JamesByers/fireflies_project/assets/800kHz_original_and_level_shifted_double_1_5.png

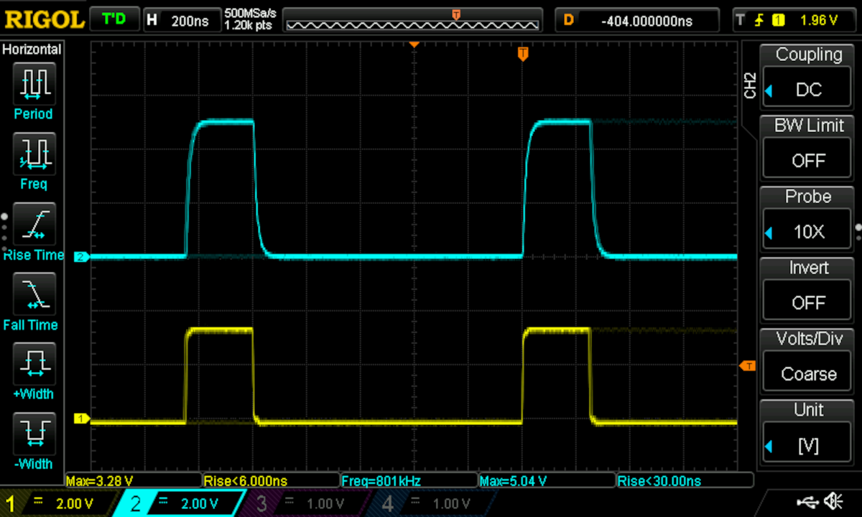
assets/800kHz_original_and_level_shifted_double_1_5.png
