JamesByers/fireflies_project/assets/Fireflies_2_1_0_board_3d.png

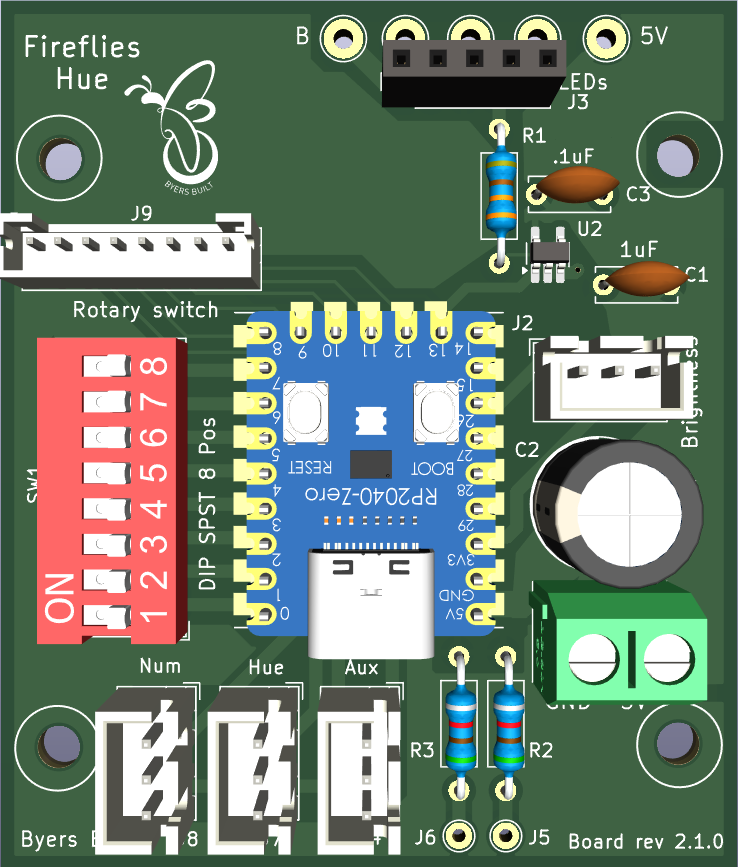
assets/Fireflies_2_1_0_board_3d.png
