JamesByers/fireflies_project/assets/Fireflies_hue_2_2_0_pcb_design.png

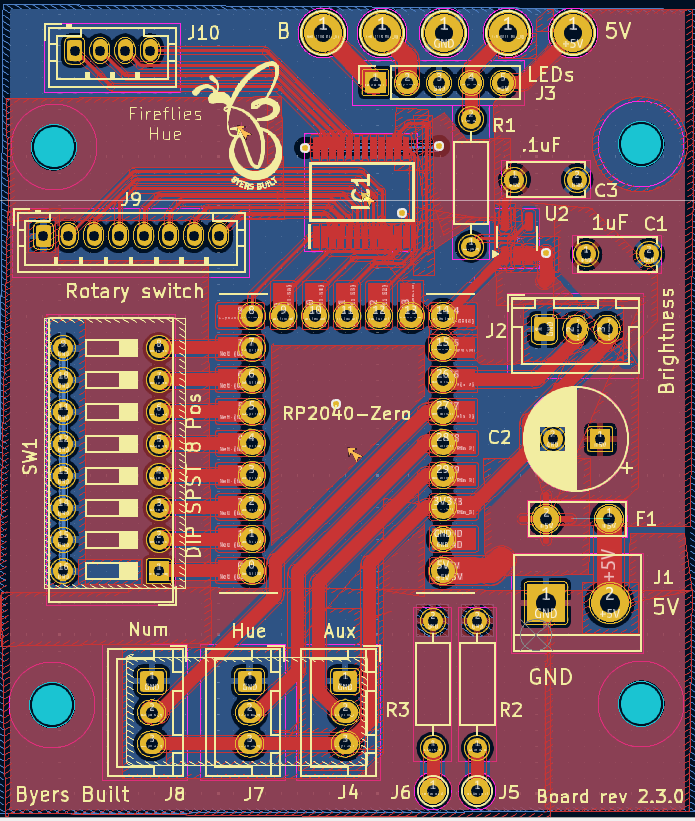
assets/Fireflies_hue_2_2_0_pcb_design.png
