JamesByers/fireflies_project/assets/Fireflies_hue_control_template.png

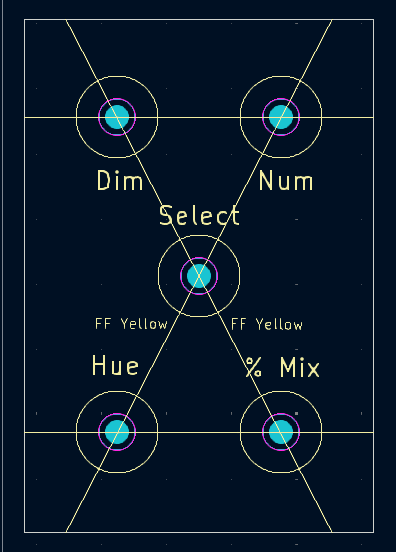
assets/Fireflies_hue_control_template.png
