JamesByers/fireflies_project/assets/Fireflies_hue_RS485_daughter_board_1_0_0_3d.png

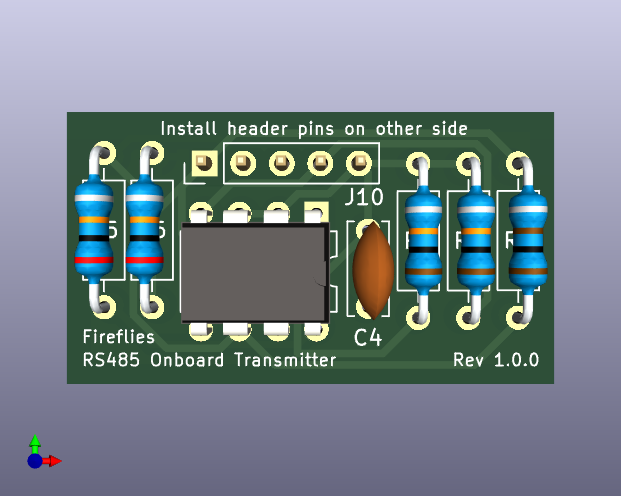
assets/Fireflies_hue_RS485_daughter_board_1_0_0_3d.png
