JamesByers/fireflies_project/assets/Fireflies_v2_rs485_daughter_board_schematic.pdf

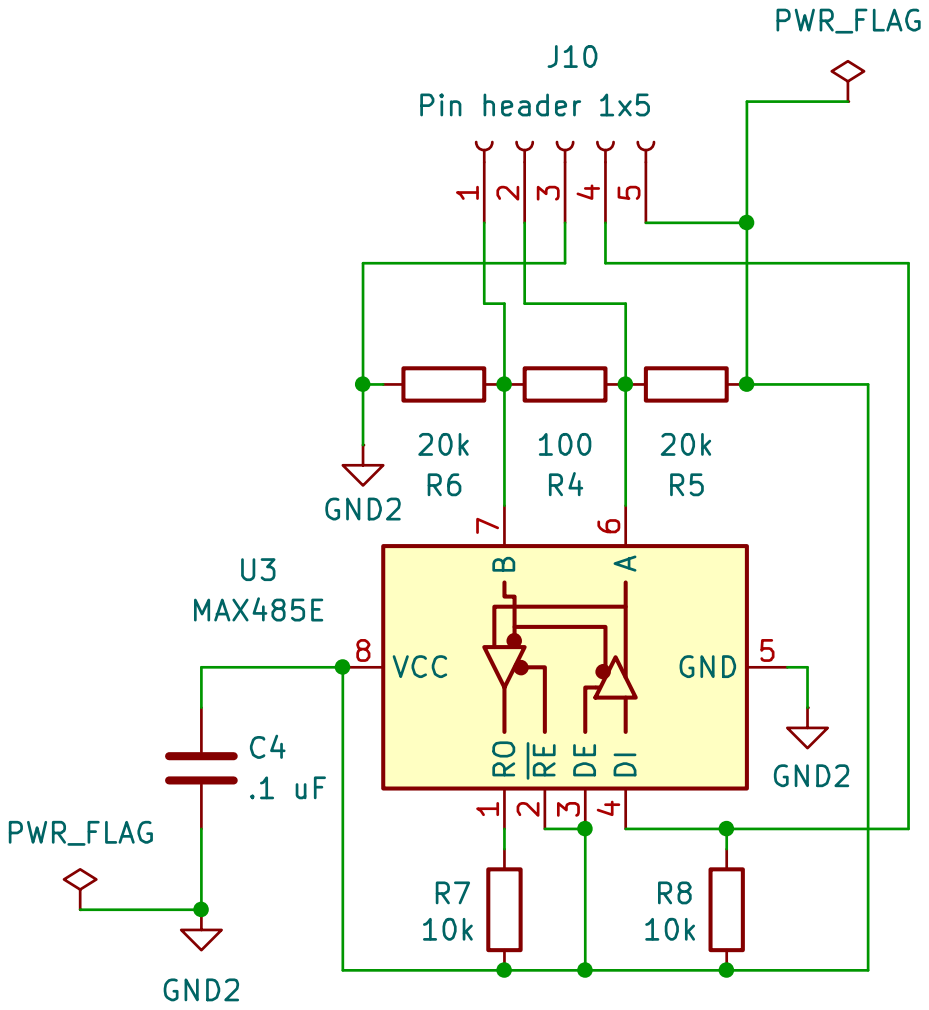
[picture p11: page 1]
