JamesByers/fireflies_project/assets/Fireflies_2_0_1_schematic.pdf

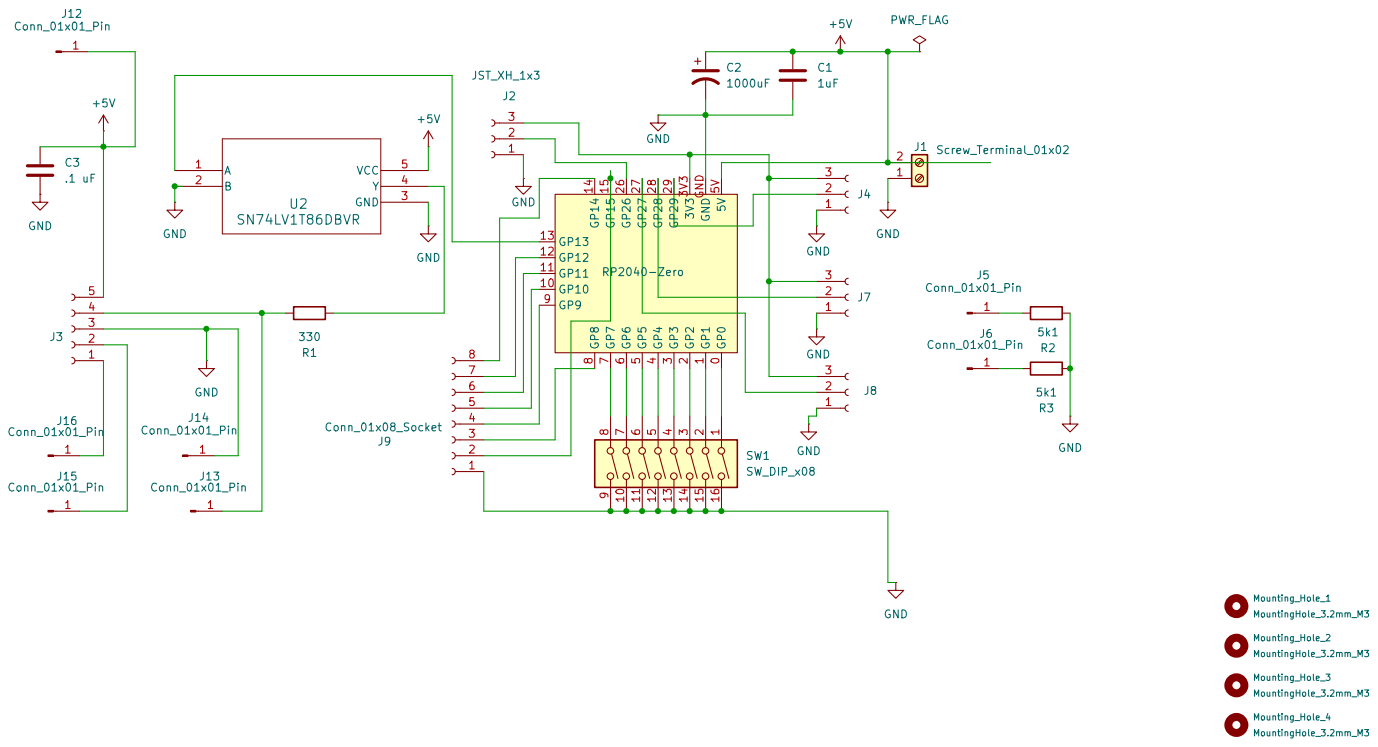
[picture p12: page 1]
