JamesByers/fireflies_project/(commit log)

2024-09-30 Added gerber file for v2.2.0 board
2024-09-30 added v2.0.0 board with parts image
